ot-conclave/GigaDiode/jvc43_bom.xlsx

Reference | Qty | Value | Footprint | Part# | Voltage | Tolerance | Isat
C101 C211 C212 C213 C214 C215 C216 C217 C218 C219 C220 C221 C222 C223 C224 C225 C226 C227 C228 C311 C312 C313 C314 C315 C316 C317 C318 C319 C320 C321 C322 C323 C324 C325 C326 C327 C328 | 37 | 10n | Capacitor_SMD:C_0603_1608Metric |  | 6.3V
C201 C202 C203 C204 C301 C302 C303 C304 | 8 | 22n | Capacitor_SMD:C_0603_1608Metric |  | 16V
C205 C206 C207 C208 C305 C306 C307 C308 | 8 | 22n | Capacitor_SMD:C_0805_2012Metric | CGA4J3X7R2E223K125AE | 250V
C209 C309 | 2 | 1n | Capacitor_SMD:C_1206_3216Metric |  | 2kV
C210 C310 | 2 | 10u | Capacitor_SMD:C_0805_2012Metric |  | 6.3V
C405 C406 | 2 | 1u | Capacitor_SMD:C_0603_1608Metric |  | 25V
C407 C408 | 2 | 22p | Capacitor_SMD:C_0603_1608Metric
C403 C404 C409 C410 | 4 | 22u | Capacitor_SMD:C_1206_3216Metric |  | 6.3V
C401 C402 C411 | 3 | 4.7u | Capacitor_SMD:C_0805_2012Metric |  | 6.3V
D201 D301 | 2 | 1N4148WS | Diode_SMD:D_SOD-323
J201 J301 | 2 | 8P8C_LED_Shielded | myfp:RJ45_Amphenol_RJE73-188-00XX1-0X | RJE73-188-00440
J401 | 1 | USB_C_Receptacle_USB2.0 | myfp:USB_C_GCT_USB4085 | USB4085-GF-A
L201 L202 L203 L301 L302 L303 | 6 | 470 ohm | Inductor_SMD:L_0603_1608Metric | MPZ1608S601ATD25
L401 | 1 | 47uH | myfp:L_Panasonic_ETQ-P4MxxxKFM | ETQ-P4M470KFM |  |  | >3.0A
L402 | 1 | 4.2uH | myfp:L_5.8x5.8mm_cutcir_6.3mm | SRR5028-4R2Y
L403 | 1 | 6.2uH | myfp:L_5.8x5.8mm_cutcir_6.3mm | SRR5028-6R2Y
R201 R202 R203 R204 R205 R206 R207 R208 R301 R302 R303 R304 R305 R306 R307 R308 | 16 | 49.9 | Resistor_SMD:R_0603_1608Metric |  |  | 0.01
R209 R309 | 2 | 10k | Resistor_SMD:R_0603_1608Metric
R210 R211 R310 R311 | 4 | 100 | Resistor_SMD:R_0603_1608Metric
R212 R213 R214 R215 R312 R313 R314 R315 | 8 | 75 | Resistor_SMD:R_0603_1608Metric
R216 R217 R316 R317 R402 R403 | 6 | 5k1 | Resistor_SMD:R_0603_1608Metric
R219 R220 R221 R222 R319 R320 R321 R322 | 8 | dnp | Resistor_SMD:R_0402_1005Metric
R218 R223 R318 R323 | 4 | 0 | Resistor_SMD:R_0402_1005Metric
R224 R324 | 2 | 8.06k | Resistor_SMD:R_0603_1608Metric |  |  | 0.01
R401 | 1 | 2.1 | Resistor_SMD:R_0603_1608Metric
R404 R406 R407 | 3 | 100k | Resistor_SMD:R_0603_1608Metric |  |  | 0.01
R405 | 1 | 316k | Resistor_SMD:R_0603_1608Metric |  |  | 0.01
TR201 TR301 | 2 | PT61020EL | myfp:magnetics_PT61020E | PT61020EL
U201 U301 | 2 | LAN8810 | myfp:QFN-72-1EP_10x10mm_P0.5mm_EP6x6mm_ThermalVias | LAN8810-AKZE
U401 | 1 | LTC3622*DE | Package_DFN_QFN:DFN-14-1EP_3x4mm_P0.5mm_EP1.7x3.3mm | LTC3622IDE#PBF
X101 | 1 | 25 MHz | Crystal:Crystal_SMD_2520-4Pin_2.5x2.0mm | ECS-2520MV-250-CN-TR
