ot-conclave/GigaDiode/jvc43_schematic.pdf

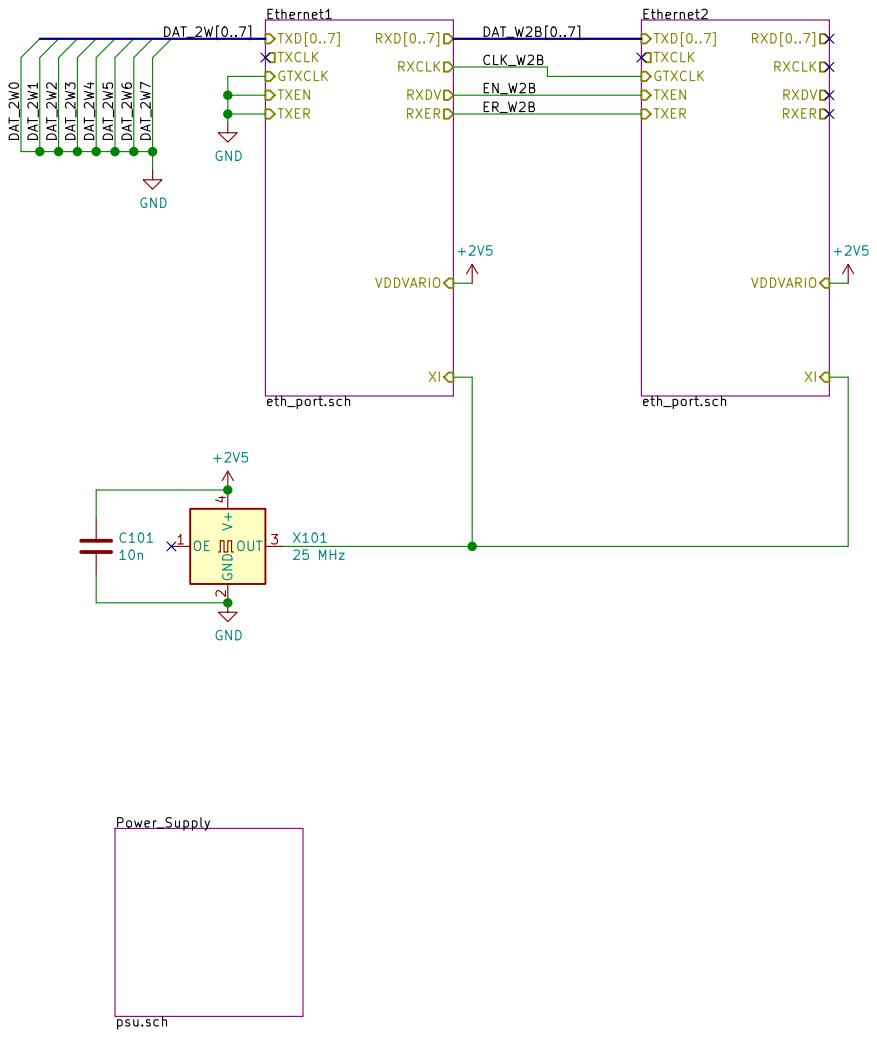
[picture p1: page 1]

Licensed under the TAPR Open Hardware License v1.0
File: jvc43.sch Sheet: / ©2022 OT Conclave

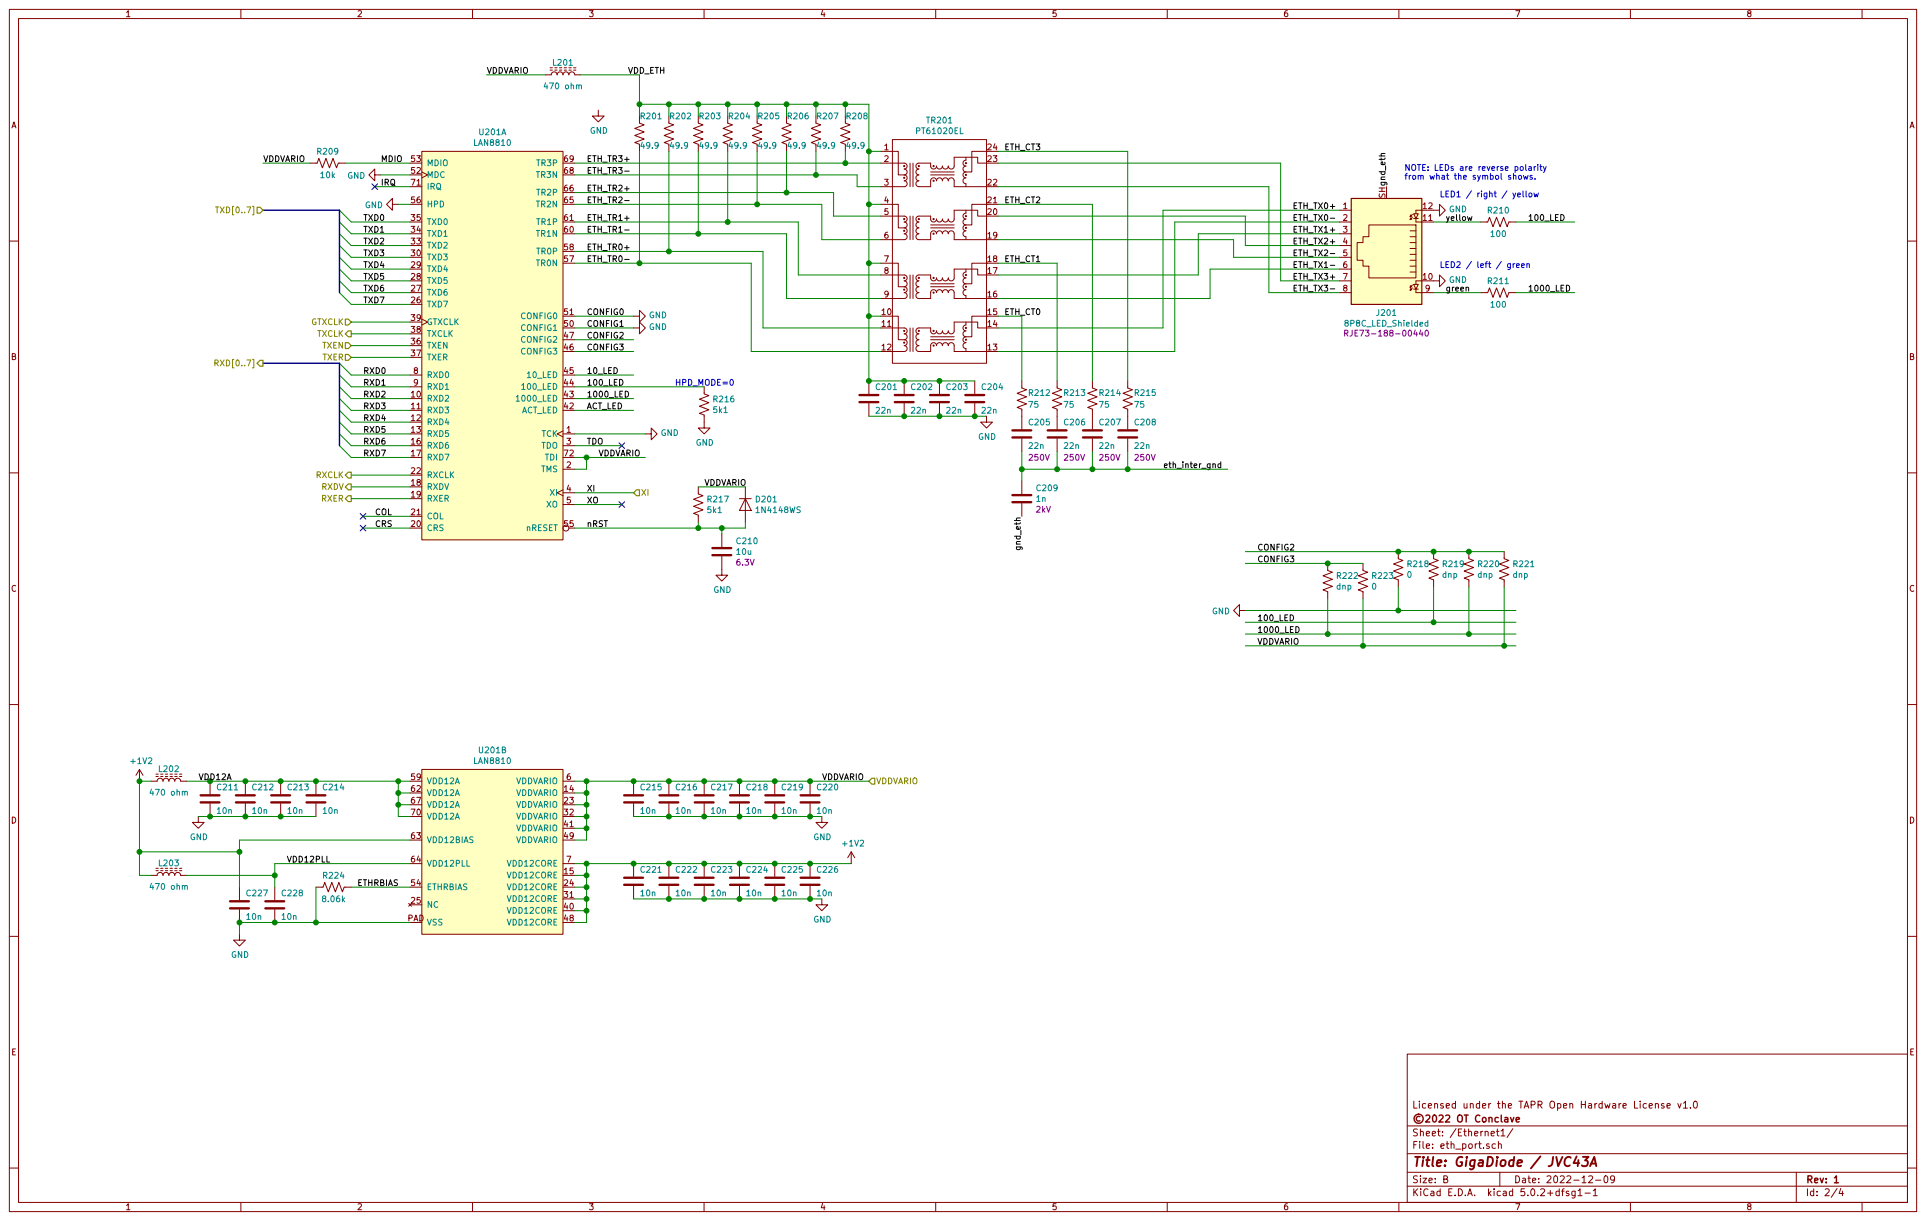
[picture p2: page 2]

NOTE: LEDs are reverse polarity
from what the symbol shows. GND GND

Licensed under the TAPR Open Hardware License v1.0
File: eth_port.sch Sheet: /Ethernet1/ ©2022 OT Conclave

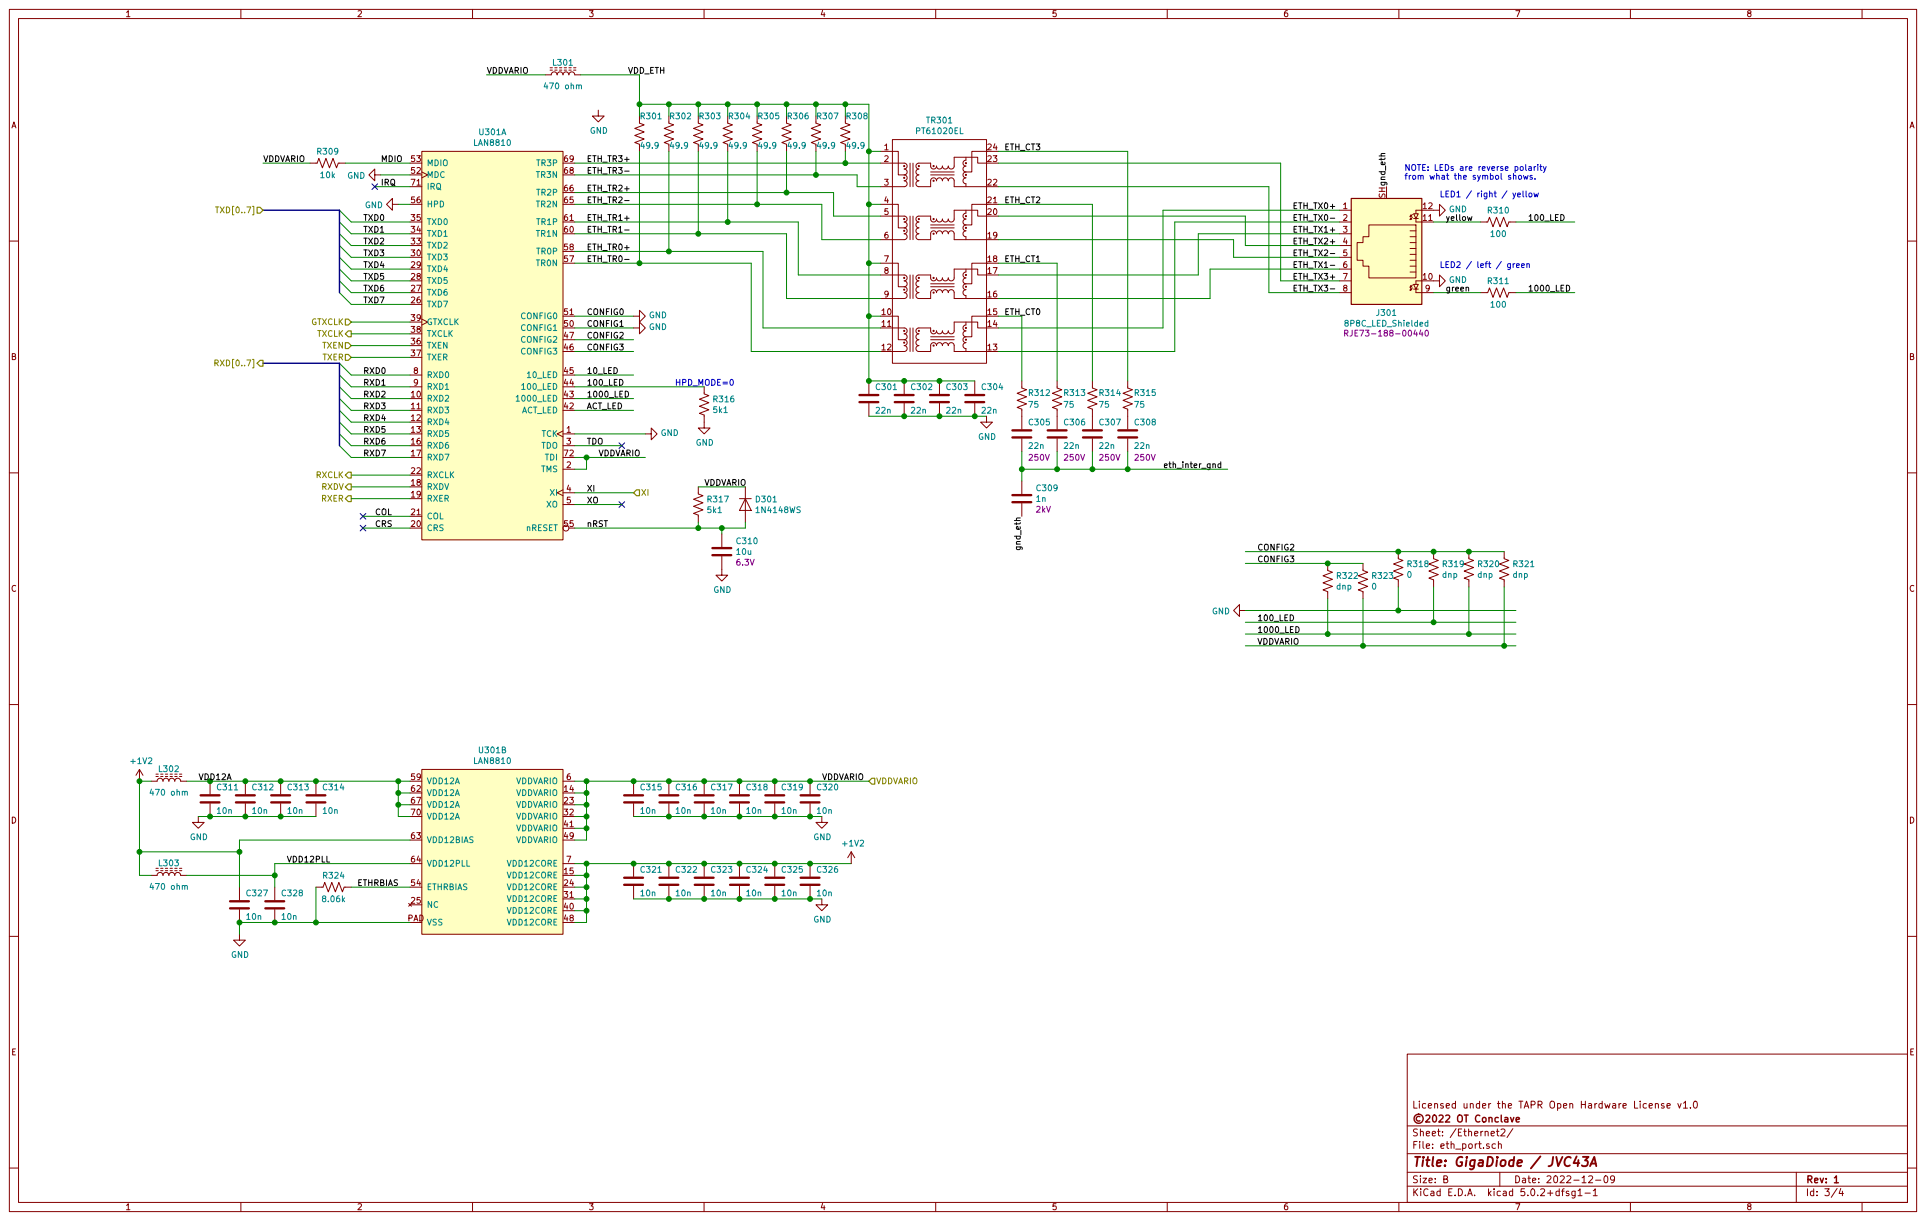
[picture p3: page 3]

NOTE: LEDs are reverse polarity
from what the symbol shows. GND GND

Licensed under the TAPR Open Hardware License v1.0
File: eth_port.sch Sheet: /Ethernet2/ ©2022 OT Conclave

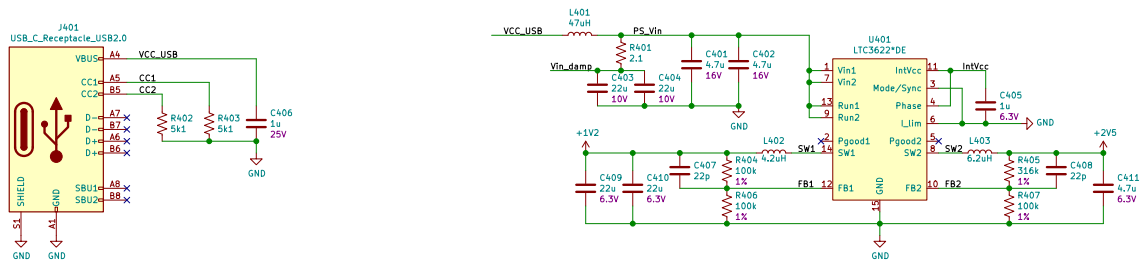
[picture p4: page 4]
