ot-conclave/GigaDiode/jvc43.kicad_pcb

## KiCad design jvc43.kicad_pcb (2022-12-10)

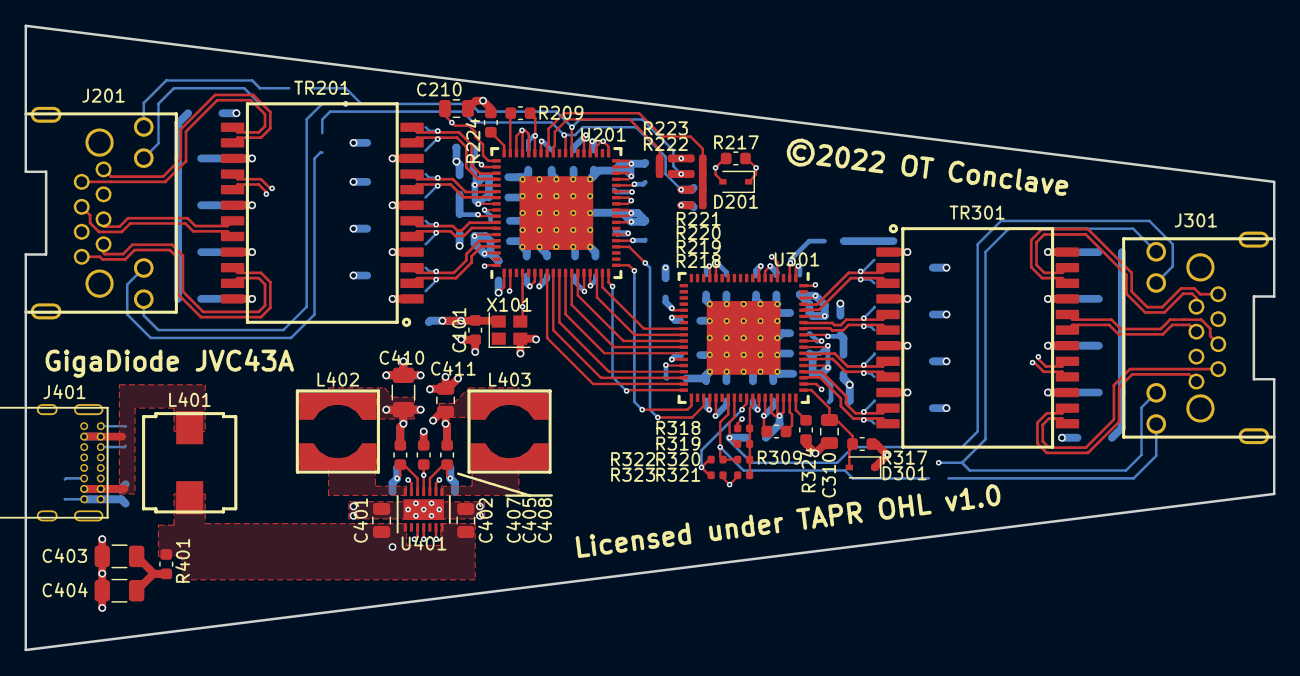
[picture p5: board jvc43.kicad_pcb from above]

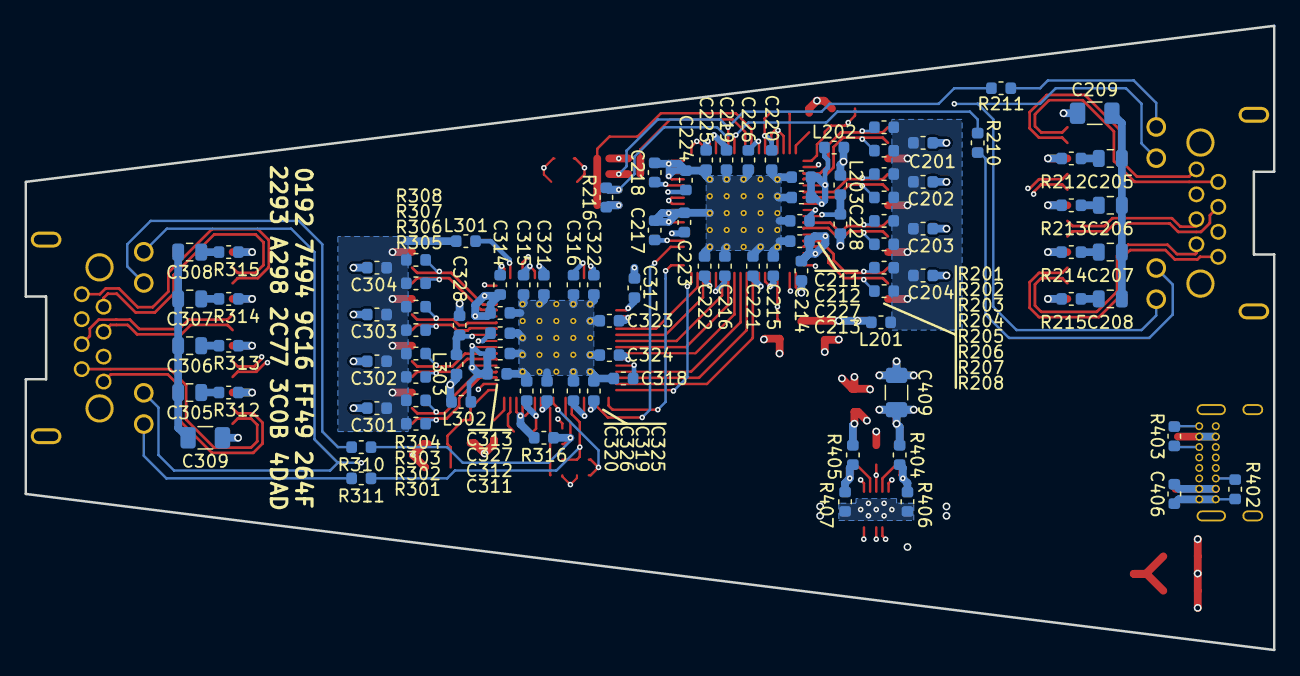
[picture p6: board jvc43.kicad_pcb from below]

Board: 6 copper layers, 101.6 x 50.8 mm, 143 parts (98 on the bottom side), 101 nets.

Parts:
C101, C211, C212, C213, C214, C215, C216, C217, C218, C219, C220, C221, C222, C223, C224, C225, C226, C227, C228, C311, C312, C313, C314, C315, C316, C317, C318, C319, C320, C321, C322, C323, C324, C325, C326, C327, C328: 10n; C_0603_1608Metric
C201, C202, C203, C204, C301, C302, C303, C304: 22n; C_0603_1608Metric
C205, C206, C207, C208, C305, C306, C307, C308: 22n; C_0805_2012Metric
C209, C309: 1n; C_1206_3216Metric
C210, C310: 10u; C_0805_2012Metric
C401, C402, C411: 4.7u; C_0805_2012Metric
C403, C404, C409, C410: 22u; C_1206_3216Metric
C405, C406: 1u; C_0603_1608Metric
C407, C408: 22p; C_0603_1608Metric
D201, D301: 1N4148WS; D_SOD-323
J201, J301: 8P8C_LED_Shielded; RJ45_Amphenol_RJE73-188-00XX1-0X
J401: USB_C_Receptacle_USB2.0; USB_C_GCT_USB4085
L201, L202, L203, L301, L302, L303: 470 ohm; L_0603_1608Metric
L401: 47uH; L_Panasonic_ETQ-P4MxxxKFM
L402: 4.2uH; L_5.8x5.8mm_cutcir_6.3mm
L403: 6.2uH; L_5.8x5.8mm_cutcir_6.3mm
R201, R202, R203, R204, R205, R206, R207, R208, R301, R302, R303, R304, R305, R306, R307, R308: 49.9; R_0603_1608Metric
R209, R309: 10k; R_0603_1608Metric
R210, R211, R310, R311: 100; R_0603_1608Metric
R212, R213, R214, R215, R312, R313, R314, R315: 75; R_0603_1608Metric
R216, R217, R316, R317, R402, R403: 5k1; R_0603_1608Metric
R218, R223, R318, R323: 0; R_0402_1005Metric
R219, R220, R221, R222, R319, R320, R321, R322: dnp; R_0402_1005Metric
R224, R324: 8.06k; R_0603_1608Metric
R401: 2.1; R_0603_1608Metric
R404, R406, R407: 100k; R_0603_1608Metric
R405: 316k; R_0603_1608Metric
TR201, TR301: PT61020EL; magnetics_PT61020E
U201, U301: LAN8810; QFN-72-1EP_10x10mm_P0.5mm_EP6x6mm_ThermalVias
U401: LTC3622*DE; DFN-14-1EP_3x4mm_P0.5mm_EP1.7x3.3mm
X101: 25 MHz; Crystal_SMD_2520-4Pin_2.5x2.0mm

Connections:
+1V2: C221.1, C222.1, C223.1, C224.1, C225.1, C226.1, C227.1, C321.1, C322.1, C323.1, C324.1, C325.1, C326.1, C327.1, C407.1, C409.1, C410.1, L202.1, L203.1, L302.1, L303.1, L402.1, R404.1, U201.7, U201.15, U201.24, U201.31, U201.40, U201.48, U201.63, U301.7, U301.15, U301.24, U301.31, U301.40, U301.48, U301.63
+2V5: C101.1, C215.1, C216.1, C217.1, C218.1, C219.1, C220.1, C315.1, C316.1, C317.1, C318.1, C319.1, C320.1, C408.1, C411.1, D201.1, D301.1, L201.1, L301.1, L403.2, R209.2, R217.1, R221.2, R223.2, R309.2, R317.1, R321.2, R323.2, R405.1, U201.2, U201.6, U201.14, U201.23, U201.32, U201.41, U201.49, U201.72, U301.2, U301.6, U301.14, U301.23, U301.32, U301.41, U301.49, U301.72, X101.4
/CLK_W2B: U201.22, U301.39
/EN_W2B: U201.18, U301.36
/ER_W2B: U201.19, U301.37
/Ethernet1/100_LED: R210.1, R216.1, R219.2, U201.44
/Ethernet1/1000_LED: R211.1, R220.2, R222.2, U201.43
/Ethernet1/CONFIG2: R218.1, R219.1, R220.1, R221.1, U201.47
/Ethernet1/CONFIG3: R222.1, R223.1, U201.46
/Ethernet1/ETHRBIAS: R224.1, U201.54
/Ethernet1/ETH_CT0: R212.1, TR201.15
/Ethernet1/ETH_CT1: R213.1, TR201.18
/Ethernet1/ETH_CT2: R214.1, TR201.21
/Ethernet1/ETH_CT3: R215.1, TR201.24
/Ethernet1/ETH_TR0+: R202.2, TR201.11, U201.58
/Ethernet1/ETH_TR0-: R201.2, TR201.12, U201.57
/Ethernet1/ETH_TR1+: R204.2, TR201.8, U201.61
/Ethernet1/ETH_TR1-: R203.2, TR201.9, U201.60
/Ethernet1/ETH_TR2+: R206.2, TR201.5, U201.66
/Ethernet1/ETH_TR2-: R205.2, TR201.6, U201.65
/Ethernet1/ETH_TR3+: R208.2, TR201.2, U201.69
/Ethernet1/ETH_TR3-: R207.2, TR201.3, U201.68
/Ethernet1/ETH_TX0+: J201.1, TR201.14
/Ethernet1/ETH_TX0-: J201.2, TR201.13
/Ethernet1/ETH_TX1+: J201.3, TR201.17
/Ethernet1/ETH_TX1-: J201.6, TR201.16
/Ethernet1/ETH_TX2+: J201.4, TR201.20
/Ethernet1/ETH_TX2-: J201.5, TR201.19
/Ethernet1/ETH_TX3+: J201.7, TR201.23
/Ethernet1/ETH_TX3-: J201.8, TR201.22
/Ethernet1/MDIO: R209.1, U201.53
/Ethernet1/RXD0: U201.8, U301.35
/Ethernet1/RXD1: U201.9, U301.34
/Ethernet1/RXD2: U201.10, U301.33
/Ethernet1/RXD3: U201.11, U301.30
/Ethernet1/RXD4: U201.12, U301.29
/Ethernet1/RXD5: U201.13, U301.28
/Ethernet1/RXD6: U201.16, U301.27
/Ethernet1/RXD7: U201.17, U301.26
/Ethernet1/VDD12A: C211.1, C212.1, C213.1, C214.1, L202.2, U201.59, U201.62, U201.67, U201.70
/Ethernet1/VDD12PLL: C228.1, L203.2, U201.64
/Ethernet1/VDD_ETH: C201.1, C202.1, C203.1, C204.1, L201.2, R201.1, R202.1, R203.1, R204.1, R205.1, R206.1, R207.1, R208.1, TR201.1, TR201.4, TR201.7, TR201.10
/Ethernet1/XI: U201.4, U301.4, X101.3
/Ethernet1/eth_inter_gnd: C205.2, C206.2, C207.2, C208.2, C209.1
/Ethernet1/gnd_eth: C209.2, J201.SH
/Ethernet1/green: J201.9, R211.2
/Ethernet1/nRST: C210.1, D201.2, R217.2, U201.55
/Ethernet1/yellow: J201.11, R210.2
/Ethernet2/100_LED: R310.1, R316.1, R319.2, U301.44
/Ethernet2/1000_LED: R311.1, R320.2, R322.2, U301.43
/Ethernet2/CONFIG2: R318.1, R319.1, R320.1, R321.1, U301.47
/Ethernet2/CONFIG3: R322.1, R323.1, U301.46
/Ethernet2/ETHRBIAS: R324.1, U301.54
/Ethernet2/ETH_CT0: R312.1, TR301.15
/Ethernet2/ETH_CT1: R313.1, TR301.18
/Ethernet2/ETH_CT2: R314.1, TR301.21
/Ethernet2/ETH_CT3: R315.1, TR301.24
/Ethernet2/ETH_TR0+: R302.2, TR301.11, U301.58
/Ethernet2/ETH_TR0-: R301.2, TR301.12, U301.57
/Ethernet2/ETH_TR1+: R304.2, TR301.8, U301.61
/Ethernet2/ETH_TR1-: R303.2, TR301.9, U301.60
/Ethernet2/ETH_TR2+: R306.2, TR301.5, U301.66
/Ethernet2/ETH_TR2-: R305.2, TR301.6, U301.65
/Ethernet2/ETH_TR3+: R308.2, TR301.2, U301.69
/Ethernet2/ETH_TR3-: R307.2, TR301.3, U301.68
/Ethernet2/ETH_TX0+: J301.1, TR301.14
/Ethernet2/ETH_TX0-: J301.2, TR301.13
/Ethernet2/ETH_TX1+: J301.3, TR301.17
/Ethernet2/ETH_TX1-: J301.6, TR301.16
/Ethernet2/ETH_TX2+: J301.4, TR301.20
/Ethernet2/ETH_TX2-: J301.5, TR301.19
/Ethernet2/ETH_TX3+: J301.7, TR301.23
/Ethernet2/ETH_TX3-: J301.8, TR301.22
/Ethernet2/MDIO: R309.1, U301.53
/Ethernet2/VDD12A: C311.1, C312.1, C313.1, C314.1, L302.2, U301.59, U301.62, U301.67, U301.70
/Ethernet2/VDD12PLL: C328.1, L303.2, U301.64
/Ethernet2/VDD_ETH: C301.1, C302.1, C303.1, C304.1, L301.2, R301.1, R302.1, R303.1, R304.1, R305.1, R306.1, R307.1, R308.1, TR301.1, TR301.4, TR301.7, TR301.10
/Ethernet2/eth_inter_gnd: C305.2, C306.2, C307.2, C308.2, C309.1
/Ethernet2/gnd_eth: C309.2, J301.SH
/Ethernet2/green: J301.9, R311.2
/Ethernet2/nRST: C310.1, D301.2, R317.2, U301.55
/Ethernet2/yellow: J301.11, R310.2
/Power_Supply/CC1: J401.A5, R403.1
/Power_Supply/CC2: J401.B5, R402.1
/Power_Supply/FB1: C407.2, R404.2, R406.1, U401.12
/Power_Supply/FB2: C408.2, R405.2, R407.1, U401.10
/Power_Supply/IntVcc: C405.1, U401.4, U401.11
/Power_Supply/PS_Vin: C401.1, C402.1, L401.2, R401.1, U401.1, U401.7, U401.9, U401.13
/Power_Supply/SW1: L402.2, U401.14
/Power_Supply/SW2: L403.1, U401.8
/Power_Supply/VCC_USB: C406.1, J401.A4, J401.A9, J401.B4, J401.B9, L401.1
/Power_Supply/Vin_damp: C403.1, C404.1, R401.2
GND: C101.2, C201.2, C202.2, C203.2, C204.2, C210.2, C211.2, C212.2, C213.2, C214.2, C215.2, C216.2, C217.2, C218.2, C219.2, C220.2, C221.2, C222.2, C223.2, C224.2, C225.2, C226.2, C227.2, C228.2, C301.2, C302.2, C303.2, C304.2, C310.2, C311.2, C312.2, C313.2, C314.2, C315.2, C316.2, C317.2, C318.2, C319.2, C320.2, C321.2, C322.2, C323.2, C324.2, C325.2, C326.2, C327.2, C328.2, C401.2, C402.2, C403.2, C404.2, C405.2, C406.2, C409.2, C410.2, C411.2, J201.10, J201.12, J301.10, J301.12, J401.A1, J401.A12, J401.B1, J401.B12, J401.S1, R216.2, R218.2, R224.2, R316.2, R318.2, R324.2, R402.2, R403.2, R406.2, R407.2, U201.1, U201.26, U201.27, U201.28, U201.29, U201.30, U201.33, U201.34, U201.35, U201.36, U201.37, U201.39, U201.50, U201.51, U201.52, U201.56, U201.PAD, U301.1, U301.50, U301.51, U301.52, U301.56, U301.PAD, U401.3, U401.6, U401.15, X101.2
unnamed: C205.1, R212.2
unnamed: C206.1, R213.2
unnamed: C207.1, R214.2
unnamed: C208.1, R215.2
unnamed: C305.1, R312.2
unnamed: C306.1, R313.2
unnamed: C307.1, R314.2
unnamed: C308.1, R315.2
