ot-conclave/GigaDiode/(commit log)

2022-12-05 New project
    [jvc43.kicad_pcb, jvc43.sch]
2022-12-05 Created schematic symbol for LAN8810 chip.
    [eth_port.sch]
2022-12-05 - Created QFN72 footprint for LAN8810 chip - Started basic schematic power bypassing - Imported into layout to get an initial look
    [eth_port.sch, jvc43.kicad_pcb, jvc43.sch]
2022-12-06 - Picked a GigE transformer - Created schematic symbol & footprint for it - Added to design with bare hookup to PHY
    [eth_port.sch, jvc43.kicad_pcb]
2022-12-06 - Selected a shielded RJ45 with dual LEDs, with the cable orientation such that it makes the transformer-to-RJ45 wiring nice. - Added a second whole Ethernet port and connected the two ports together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
    [eth_port.sch, jvc43.kicad_pcb, jvc43.sch]
2022-12-06 - Added termination network to line side of Ethernet transformer - Started vaguely laying out the big pieces of Ethernet1 block - Set PCB layout to be six layers - Added layout layer identification t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
    [eth_port.sch, jvc43.kicad_pcb]
2022-12-06 - Adjusted RJ45 main pin thru-holes to have only an 8mil-wide ring, instead of 10mil. There was just not enough room for routing. - Fixed wiring to RJ45, it was 3/4 and 5/6 instead of 3/6 and 4/5, wh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
    [eth_port.sch, jvc43.kicad_pcb]
2022-12-07 Lots of work. - Bussed the two Ethernet blocks together in top level schematic - Mashed Ethernet1 input wires to ground - Added hierarchical label for crystal-in pin - Added a couple more net labels 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
    [eth_port.sch, jvc43.kicad_pcb, jvc43.sch]
2022-12-08 - Added copyright and license headers to the schematic - Started in on the power supply, from 0 to 80% or so, including documentation
    [eth_port.sch, jvc43.kicad_pcb, jvc43.sch, psu.sch]
2022-12-08 Added license/copyright to layout file.
    [jvc43.kicad_pcb]
2022-12-08 Experimenting with plotting options. "Plot sheet reference on all layers" ensures that the licensing text is included in all Gerber output files. The board houses might get annoyed, will have to see.
    [jvc43.kicad_pcb]
2022-12-08 Major work on the power supply: - Swapped the input filter inductor for a significantly smaller one - Basically finished laying out the switching supply
    [jvc43.kicad_pcb, psu.sch]
2022-12-08 Forward progress - Started the real 1.2V power plane - Placed and routed most of PHY1 decoupling capacitors - Placed and partly routed transformer2 PHY-side resistors & capacitors - Labelled a few mo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
    [eth_port.sch, jvc43.kicad_pcb, jvc43.sch]
2022-12-08 Routed Ethernet2 RJ45-to-transformer area.
    [jvc43.kicad_pcb]
2022-12-08 Routed 3/4 of the PHY2 decoupling caps, plus the PHY1-to-PHY2 data lines (but not yet the enables/clock). Had to alter some traces and clearances down from 8 mils to 7 mils to get a couple things to 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
    [jvc43.kicad_pcb]
2022-12-09 - Routed the PHY2-to-magnetics diff pairs - Routed all the remaining PHY2 decoupling caps, and even the chip inductors, except for the VDD_ETH one - Spent some time swizzling rear silkscreen labels t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
    [jvc43.kicad_pcb]
2022-12-09 Placed and routed the tricky last 1/4 of bypass caps for PHY1.
    [jvc43.kicad_pcb]
2022-12-09 - Selected, schematic'd, placed & routed a crystal oscillator - Filled various internal planes to even out board thickness as well as improve EMI performance - Added some identifying text to the top 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
    [eth_port.sch, jvc43.kicad_pcb, jvc43.sch]
2022-12-09 - Removed C201/C301 which were the first two bypass caps on VCC_ETH - Placed last two components - Tweaked some planes, I think? - Finished routing all nets from the current schematic!!!
    [eth_port.sch, jvc43.kicad_pcb, jvc43.sch]
2022-12-09 - Added HPD_MODE strap resistor - Narrowed down from an RJ45 family P/N to a very specific P/N - Added RJ45 LED hookups - Added CONFIG0/1/2/3 hookups, including a bunch of 0402 zero-ohm options - Pla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
    [eth_port.sch, jvc43.kicad_pcb]
2022-12-09 Added an identifier to the back silkscreen
    [jvc43.kicad_pcb]
2022-12-09 Updated the title blocks / naming
    [eth_port.sch, jvc43.kicad_pcb, jvc43.sch, psu.sch]
2022-12-10 - Placed and routed the LED resistors & lines - This involved tweaking the 2kV Ethernet capacitor a bit - Also moved some front silkscreen refdes & major board texts
    [jvc43.kicad_pcb]
2022-12-10 Added RC+D circuits for power-on reset of PHY chips. Running out of room...
    [eth_port.sch, jvc43.kicad_pcb]
2022-12-10 Added PCB fab notes and board stackup diagram/requirements.
    [jvc43.kicad_pcb]
2022-12-10 Generated output fab files
    [jvc43-B.Cu.gbr, jvc43-B.Mask.gbr, jvc43-B.Paste.gbr, jvc43-B.SilkS.gbr, jvc43-Dwgs.User.gbr, jvc43-Edge.Cuts.gbr, jvc43-F.Cu.gbr, jvc43-F.Mask.gbr]
2022-12-10 Exported schematic PDF and BoM, the latter manually massaged. Added a couple missing part #s for big things which seemed important.
    [eth_port.sch, jvc43_bom.xlsx, psu.sch]
