ot-conclave/GigaDiode/(notices)

Notices in the files:
jvc43.kicad_pcb:
Licensed under TAPR OHL v1.0
